StickyEthan/ContinuO_Library/README.md

# ContinuO_Library
 Library dependency of REPOWER-ContinuO projects (GIT Submodule)
