StickyEthan/ContinuO_Library/3D_models/XT60PW-M.STEP

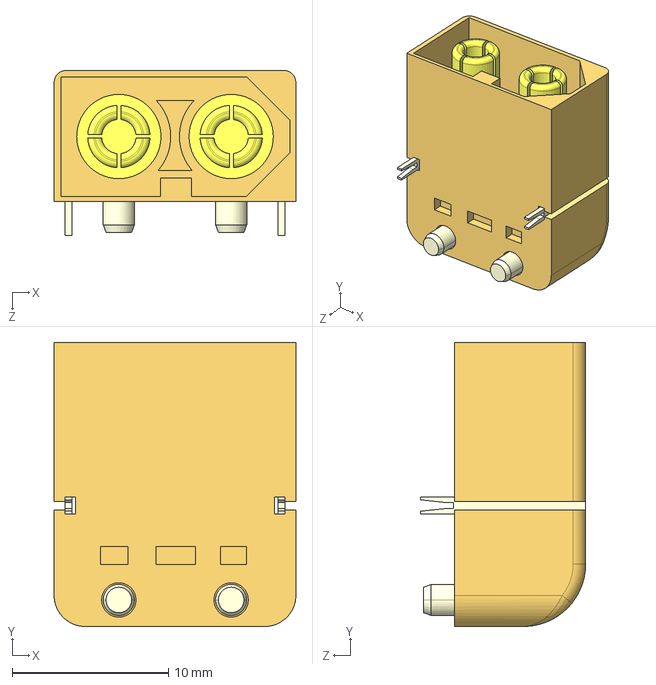
[picture p1: CAD file, 2025-01-31]
3D_models/XT60PW-M.STEP
15.5 x 18.2 x 10.6 mm
