StickyEthan/ContinuO_Library/3D_models/1211.stp

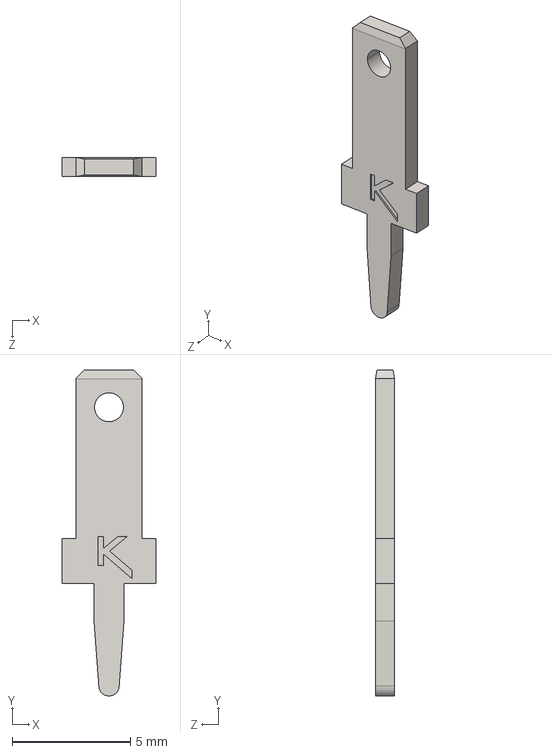
[picture p2: CAD file, 2025-01-27]
3D_models/1211.stp
3.96 x 13.8 x 0.813 mm
