StickyEthan/ContinuO_Library/3D_models/c-62395-1-ae-3d.stp

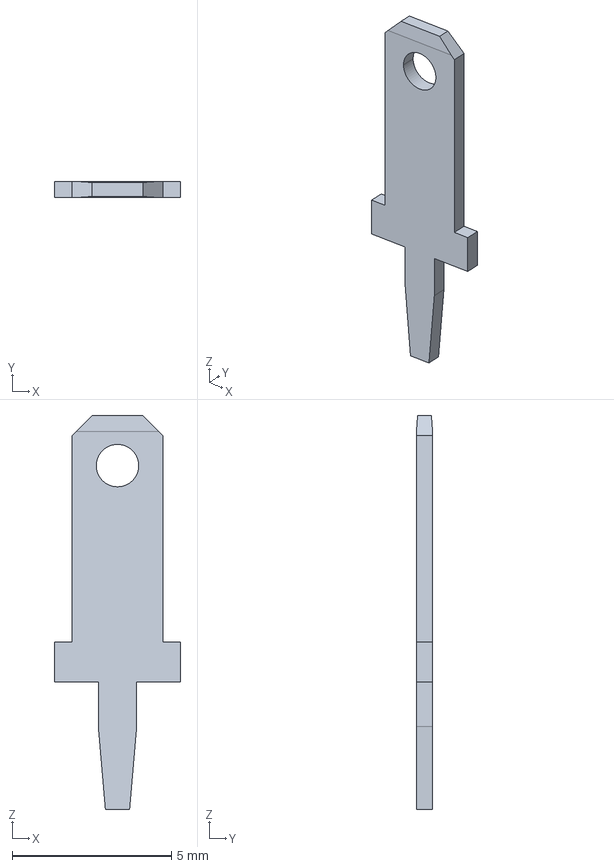
[picture p3: CAD file, 2025-01-27]
3D_models/c-62395-1-ae-3d.stp
3.96 x 0.508 x 12.4 mm
