StickyEthan/ContinuO_Library/3D_models/SMDJSeries_LTF.step

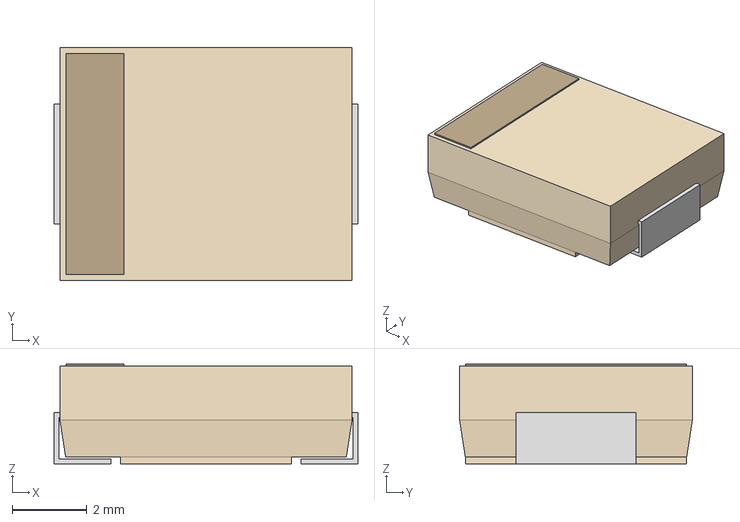
[picture p4: CAD file, 2025-01-22]
3D_models/SMDJSeries_LTF.step
8.13 x 6.22 x 2.67 mm
