StickyEthan/ContinuO_Library/3D_models/FUSE_0505-CARTRIDGE_LTF.step

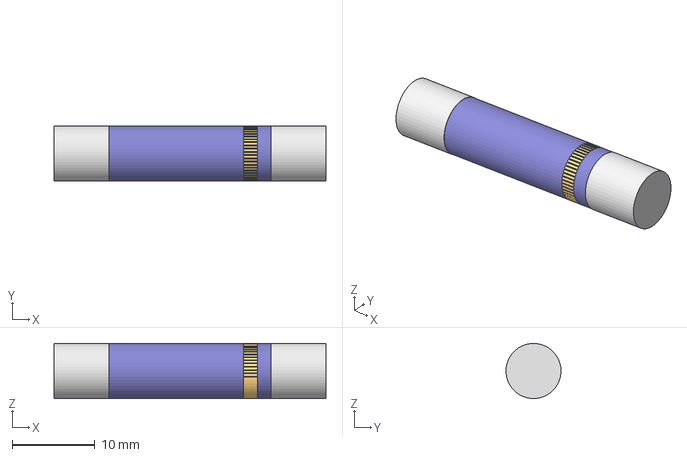
[picture p5: CAD file, 2025-01-16]
3D_models/FUSE_0505-CARTRIDGE_LTF.step
32.9 x 6.65 x 6.65 mm
