StickyEthan/ContinuO_Library/3D_models/UMF250.STEP

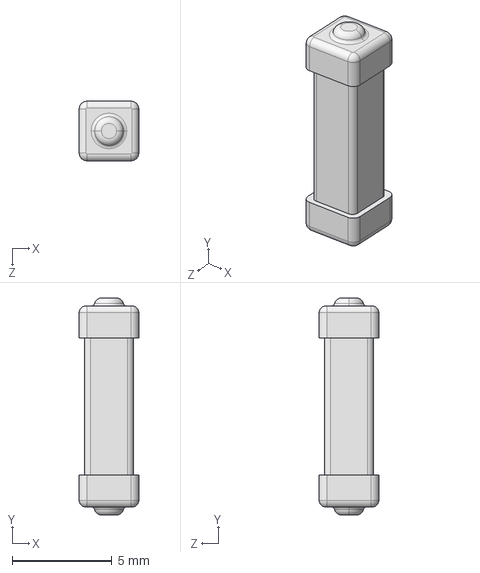
[picture p6: CAD file, 2025-01-14]
3D_models/UMF250.STEP
3.00 x 10.9 x 3.00 mm
