StickyEthan/ContinuO_Library/3D_models/217-36CTE6.stp

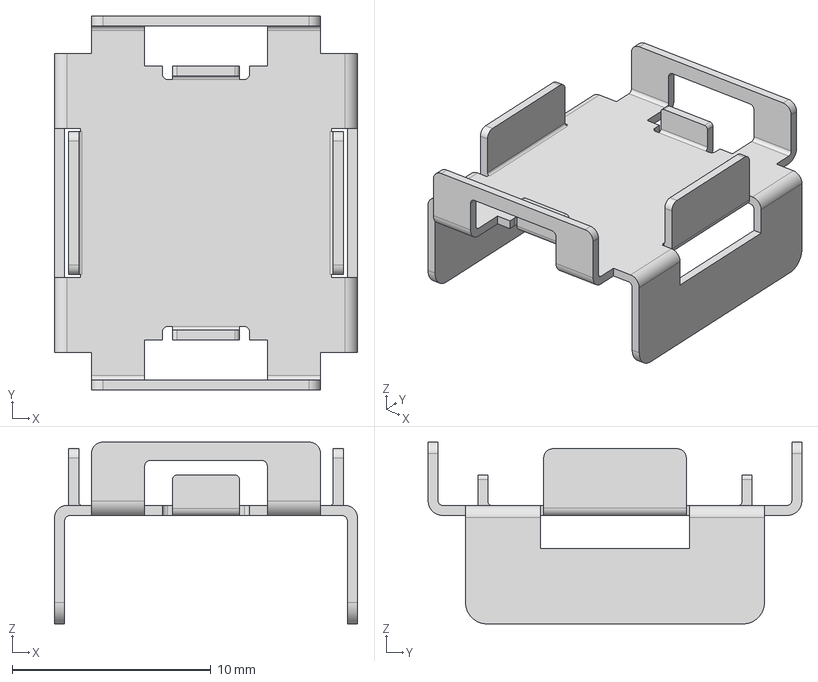
[picture p7: CAD file, 2025-01-14]
3D_models/217-36CTE6.stp
15.2 x 18.8 x 9.14 mm
