StickyEthan/ContinuO_Library/3D_models/Shunt Resistor v2.step

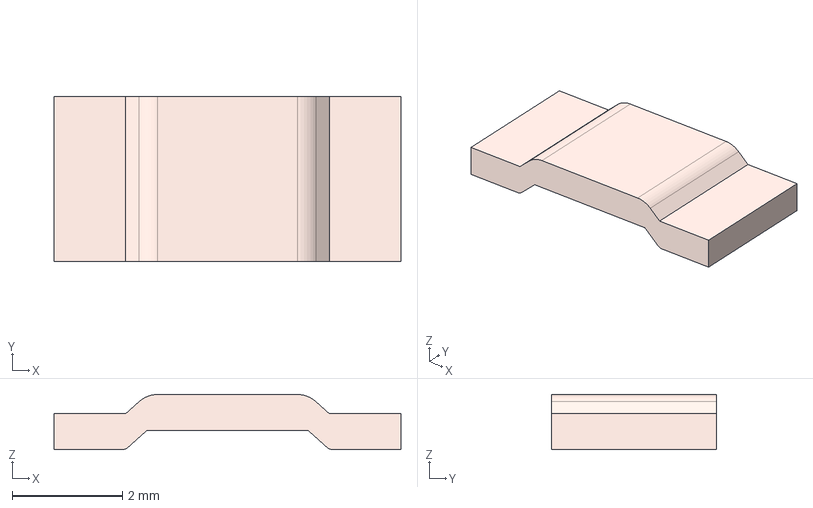
[picture p8: CAD file, 2025-01-14]
3D_models/Shunt Resistor v2.step
6.30 x 3.00 x 1.00 mm
