StickyEthan/ContinuO_Library/3D_models/Same_Sky_TBP01P1-508-02BE.step

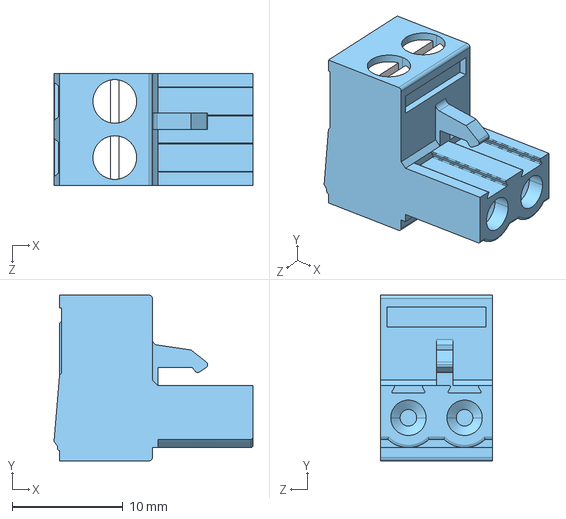
[picture p9: CAD file, 2025-01-14]
3D_models/Same_Sky_TBP01P1-508-02BE.step
18.0 x 15.0 x 10.2 mm
