StickyEthan/ContinuO_Library/3D_models/CAP_PKPZ_8X11P5_LOW_RUB.step

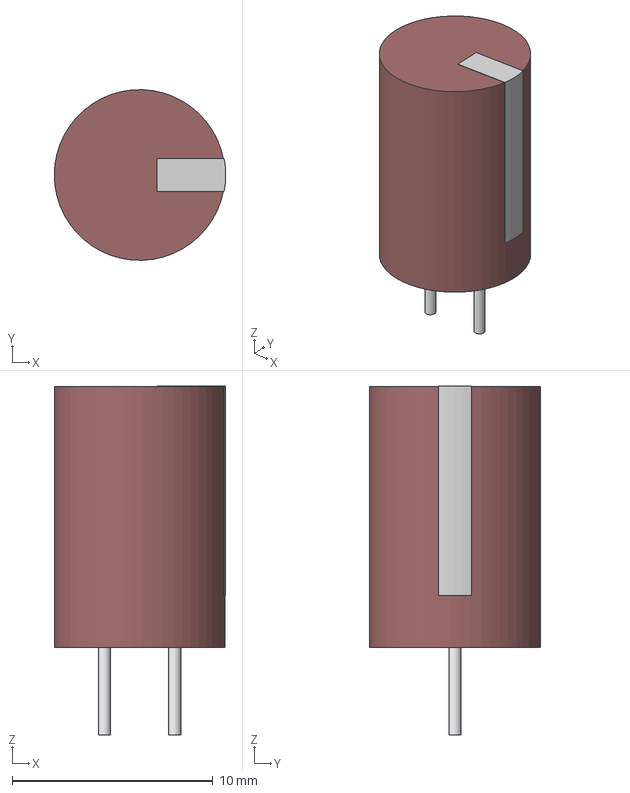
[picture p10: CAD file, 2025-01-14]
3D_models/CAP_PKPZ_8X11P5_LOW_RUB.step
8.54 x 8.50 x 17.4 mm
