StickyEthan/ContinuO_Library/3D_models/TBP01R2-508-02BE_male.step

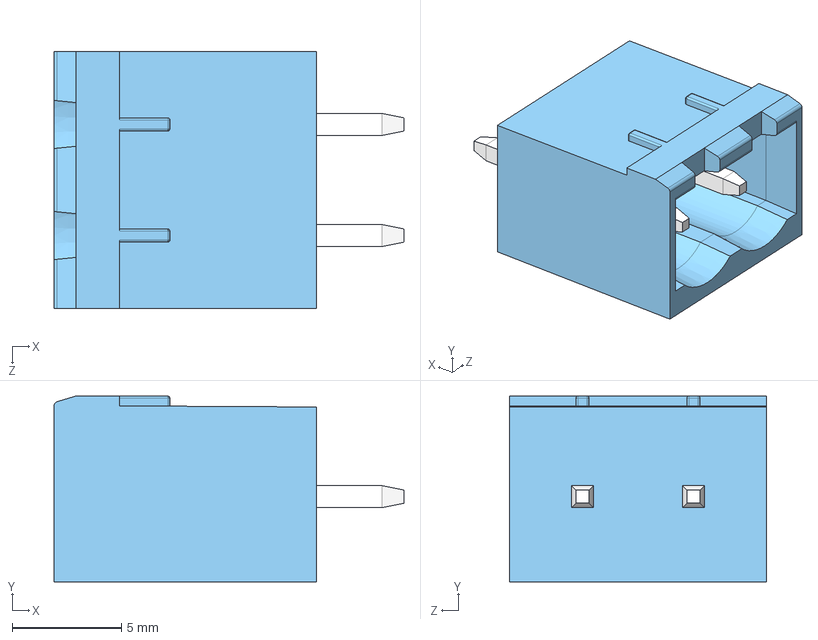
[picture p11: CAD file, 2025-01-14]
3D_models/TBP01R2-508-02BE_male.step
16.0 x 8.50 x 11.8 mm
