StickyEthan/ContinuO_Library/3D_models/RDA0015A.stp

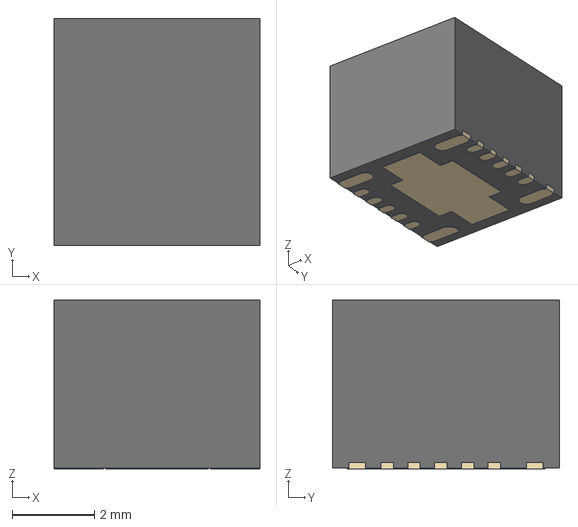
[picture p12: CAD file, 2025-01-14]
3D_models/RDA0015A.stp
5.00 x 5.50 x 4.10 mm
METAL
MOLD
