StickyEthan/ContinuO_Library/3D_models/S02B-PASK-2.STEP

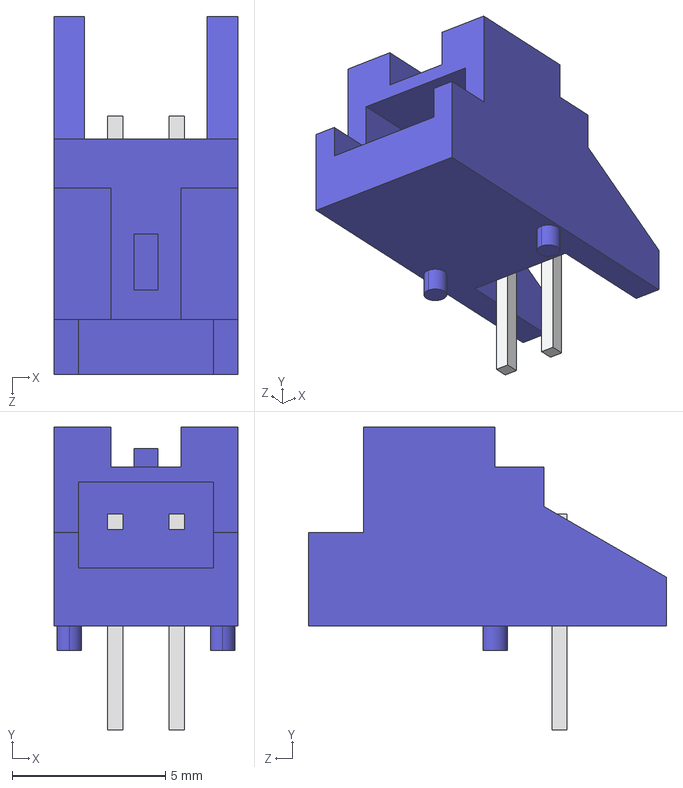
[picture p13: CAD file, 2025-01-13]
3D_models/S02B-PASK-2.STEP
6.00 x 9.90 x 11.7 mm
