StickyEthan/ContinuO_Library/3D_models/CAP_BX_12P5x30_RUB.step

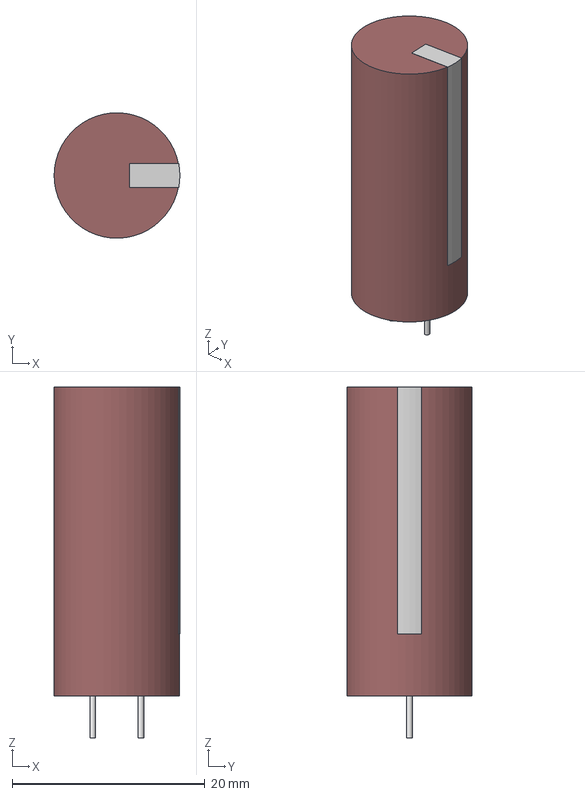
[picture p14: CAD file, 2025-01-12]
3D_models/CAP_BX_12P5x30_RUB.step
13.0 x 13.0 x 36.4 mm
