StickyEthan/ContinuO_Library/3D_models/DDF0008A.stp

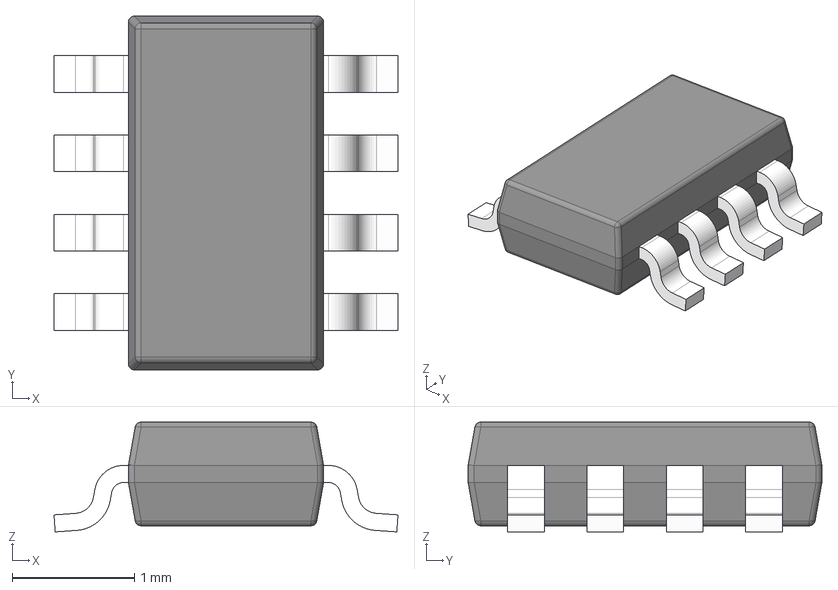
[picture p15: CAD file, 2025-01-09]
3D_models/DDF0008A.stp
2.82 x 2.90 x 0.9 mm
BODY-SO
LEAD-SO x 8
PIN1-ID
