StickyEthan/ContinuO_Library/3D_models/CAP_YX_12P5X25_RUB.step

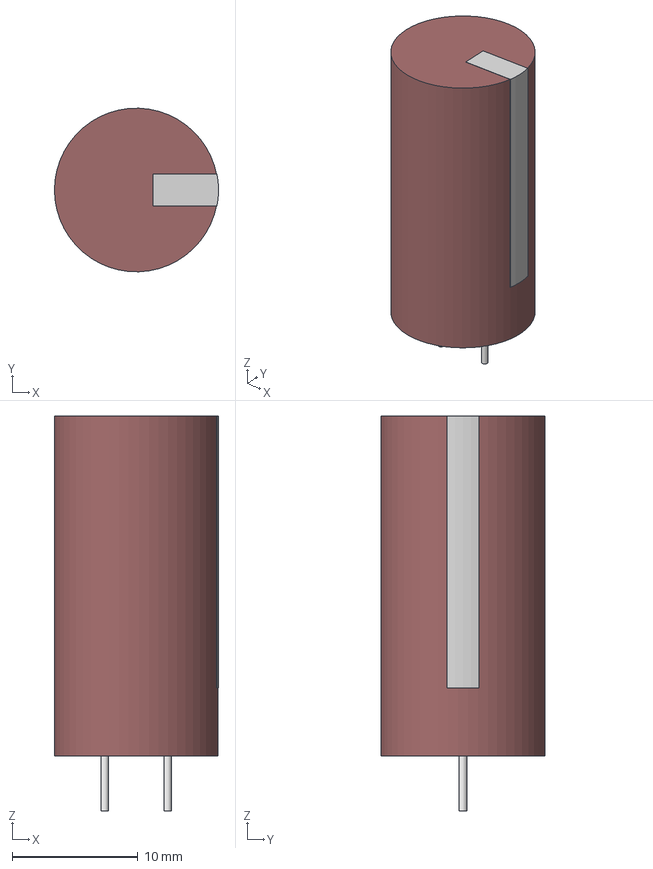
[picture p16: CAD file, 2025-01-02]
3D_models/CAP_YX_12P5X25_RUB.step
13.0 x 13.0 x 31.4 mm
