StickyEthan/ContinuO_Library/3D_models/LFPAK88_SOT1235_NEX.step

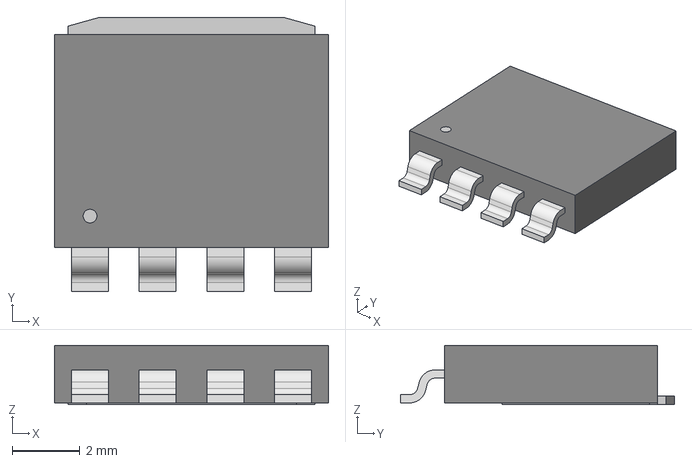
[picture p17: CAD file, 2024-12-31]
3D_models/LFPAK88_SOT1235_NEX.step
8.10 x 8.10 x 1.75 mm
