StickyEthan/ContinuO_Library/3D_models/DGK0008A.stp

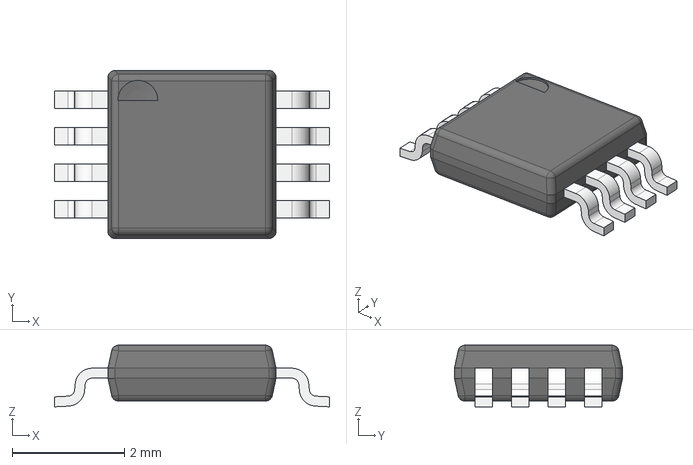
[picture p18: CAD file, 2024-12-31]
3D_models/DGK0008A.stp
4.90 x 3.00 x 1.10 mm
BODY_MUA08A
LEAD_MUA08A x 8
