StickyEthan/ContinuO_Library/3D_models/HSE05-171933.step

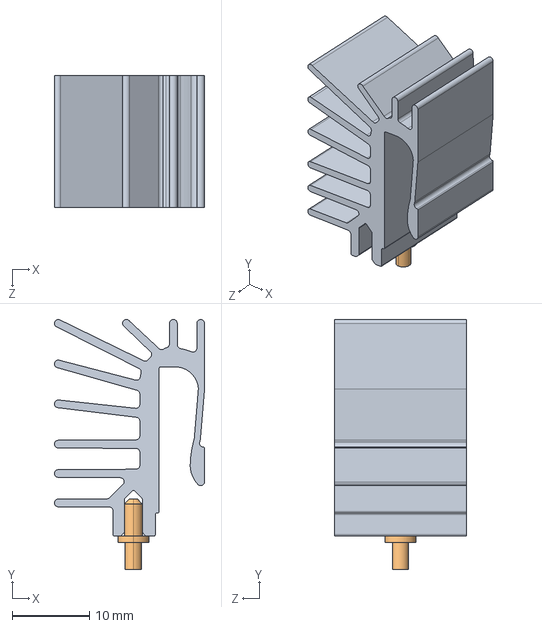
[picture p19: CAD file, 2024-12-31]
3D_models/HSE05-171933.step
19.4 x 32.3 x 17.0 mm
