StickyEthan/ContinuO_Library/3D_models/PF2203_2RF1.step

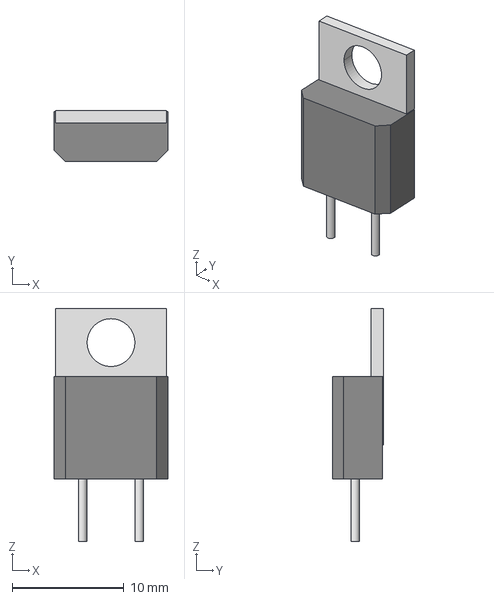
[picture p20: CAD file, 2024-12-31]
3D_models/PF2203_2RF1.step
10.2 x 4.57 x 20.8 mm
