StickyEthan/ContinuO_Library/3D_models/A785MW227M1HLAS015.stp

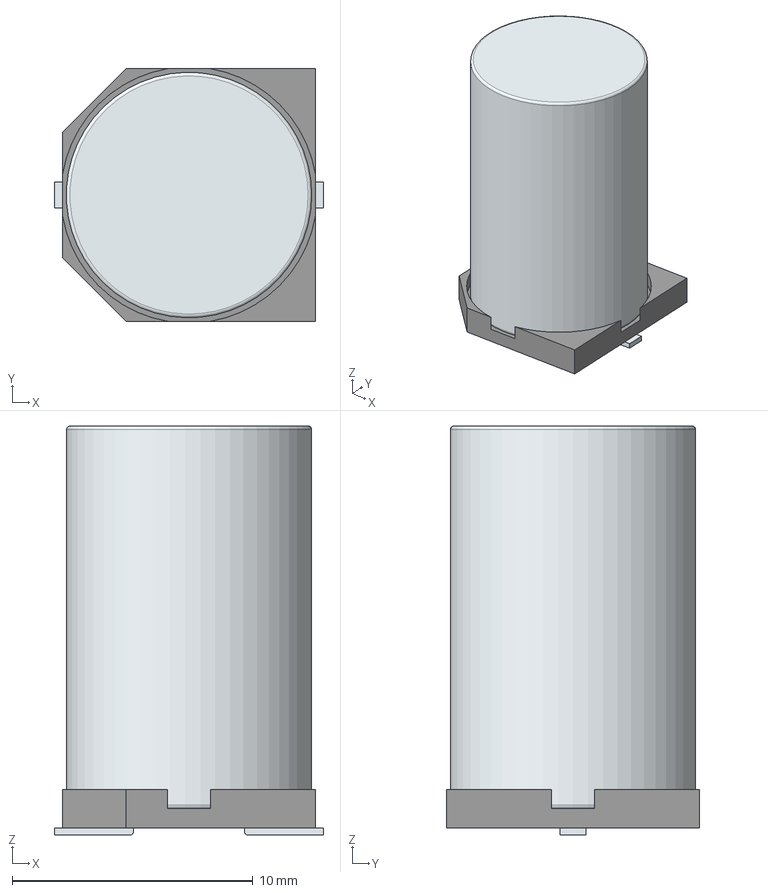
[picture p21: CAD file, 2024-12-11]
3D_models/A785MW227M1HLAS015.stp
11.2 x 10.5 x 17.0 mm
Base
Pin1Fillet
Pin2Fillet
