StickyEthan/ContinuO_Library/3D_models/V-1100-SMD.STEP

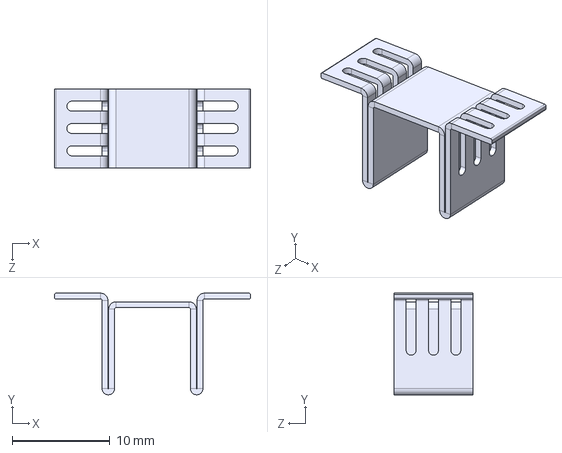
[picture p22: CAD file, 2024-12-11]
3D_models/V-1100-SMD.STEP
20.1 x 10.4 x 8.13 mm
