StickyEthan/ContinuO_Library/3D_models/ESL108M035AK5AA.step

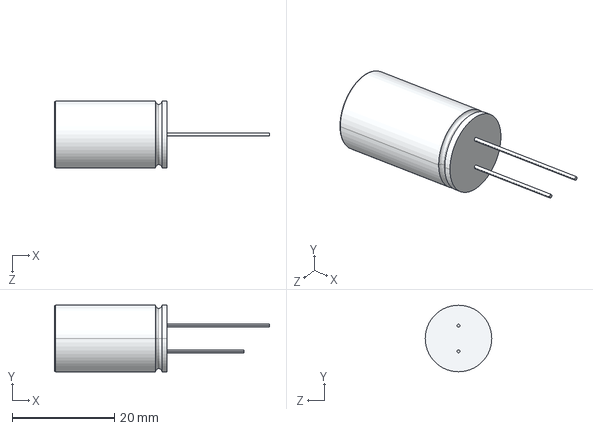
[picture p23: CAD file, 2024-12-11]
3D_models/ESL108M035AK5AA.step
42.0 x 13.0 x 13.0 mm
