StickyEthan/ContinuO_Library/3D_models/MF-MSMF075_24-2.step

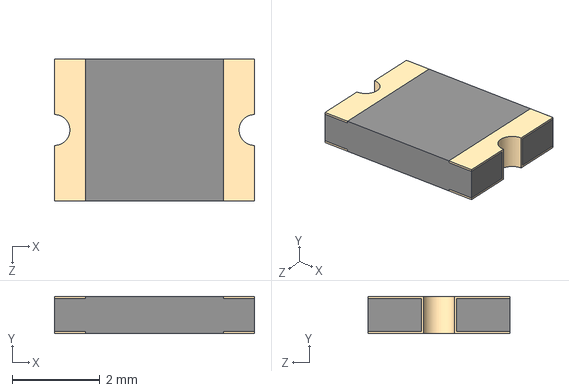
[picture p24: CAD file, 2024-11-30]
3D_models/MF-MSMF075_24-2.step
4.55 x 0.85 x 3.24 mm
