StickyEthan/ContinuO_Library/3D_models/BMR684_heatsink.stp

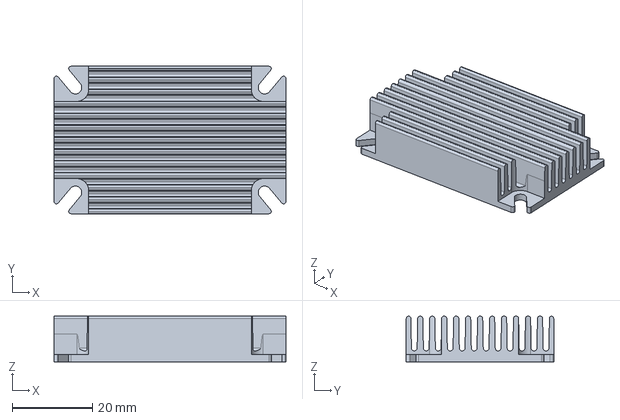
[picture p25: CAD file, 2024-11-29]
3D_models/BMR684_heatsink.stp
57.9 x 36.8 x 11.4 mm
