StickyEthan/ContinuO_Library/3D_models/UMZ250.STEP

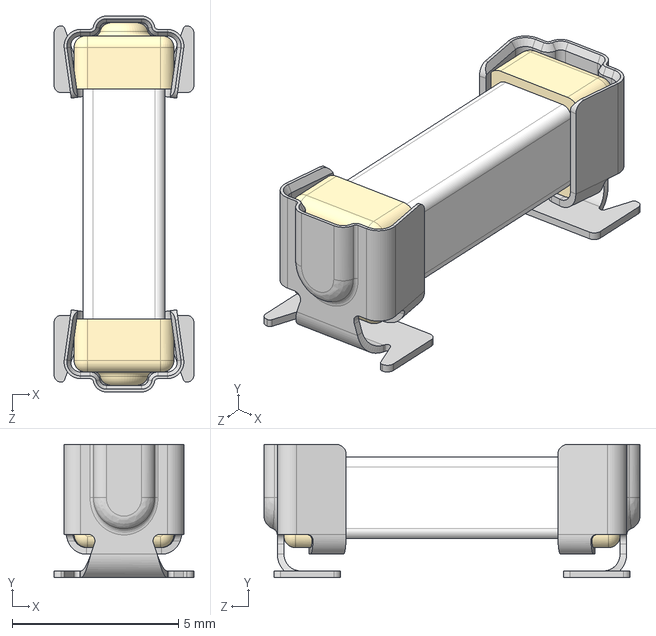
[picture p26: CAD file, 2024-11-29]
3D_models/UMZ250.STEP
4.20 x 4.00 x 11.3 mm
