StickyEthan/ContinuO_Library/3D_models/UMT-H.step

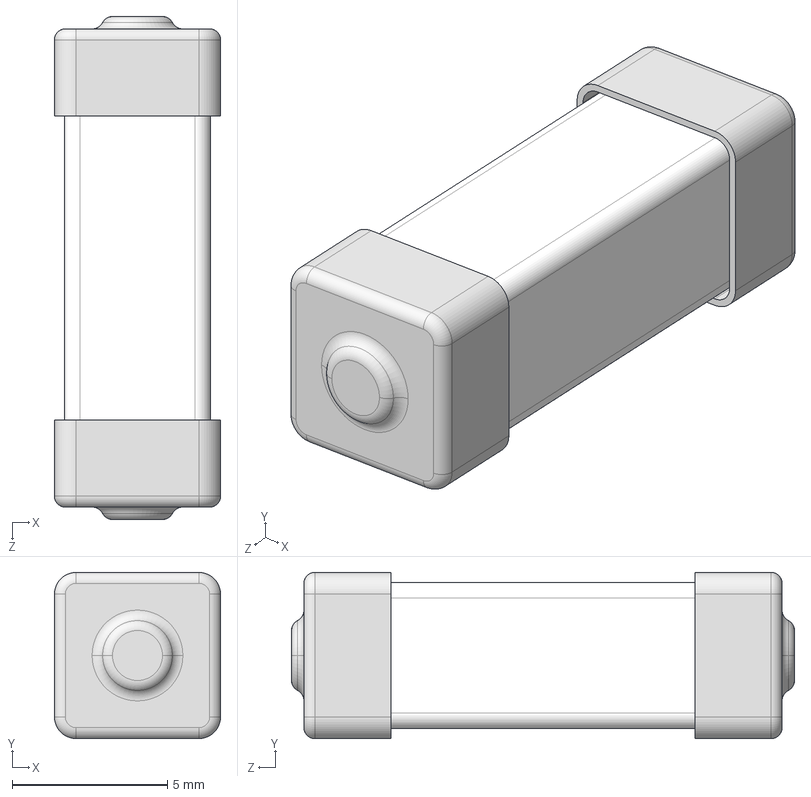
[picture p27: CAD file, 2024-11-29]
3D_models/UMT-H.step
5.35 x 5.35 x 16.2 mm
