StickyEthan/ContinuO_Library/3D_models/B02B-PASK-1.step

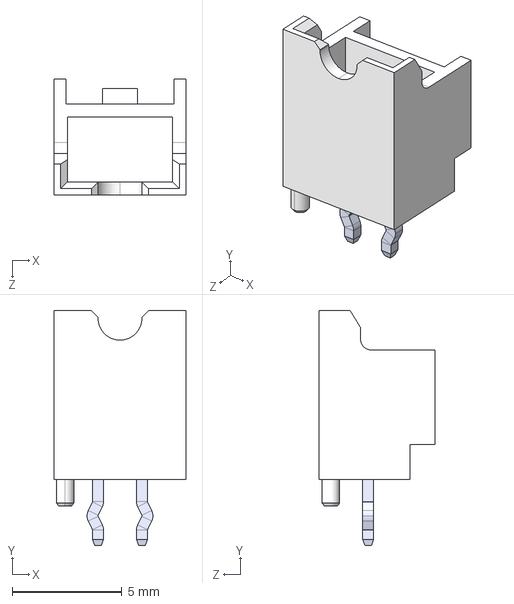
[picture p28: CAD file, 2024-11-28]
3D_models/B02B-PASK-1.step
6.00 x 10.7 x 5.30 mm
BxB-PASK(1)2-9_2boss
pin_bent x 2
