StickyEthan/ContinuO_Library/3D_models/S03B-PASK-2_LF__SN_.stp

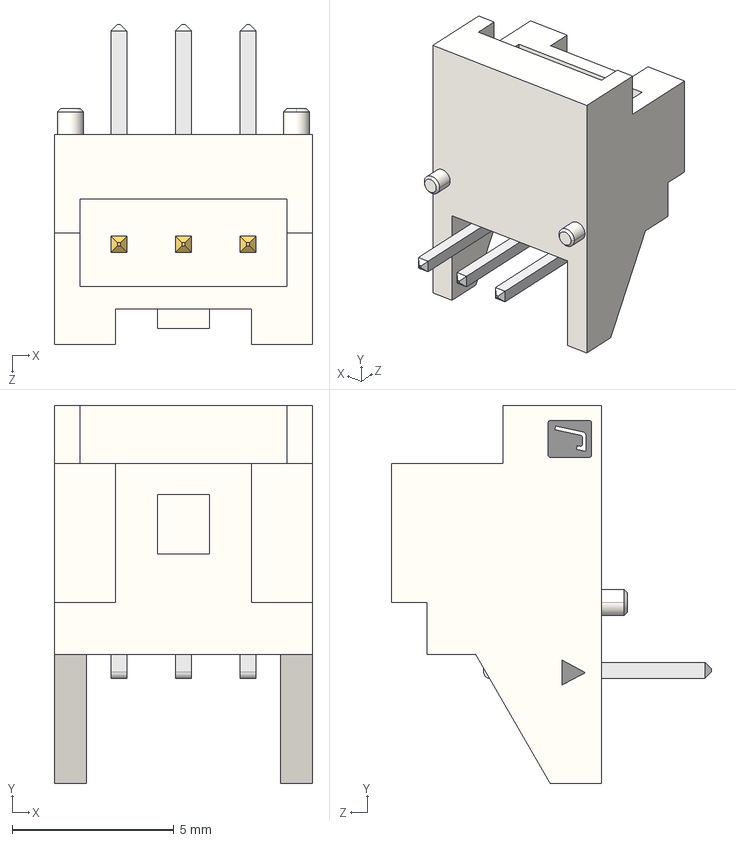
[picture p29: CAD file, 2024-11-28]
3D_models/S03B-PASK-2_LF__SN_.stp
8.00 x 11.7 x 9.90 mm
S03B-PASK-2
JST Logo adjustable
