StickyEthan/ContinuO_Library/3D_models/HTSW-102-07-F-D.step

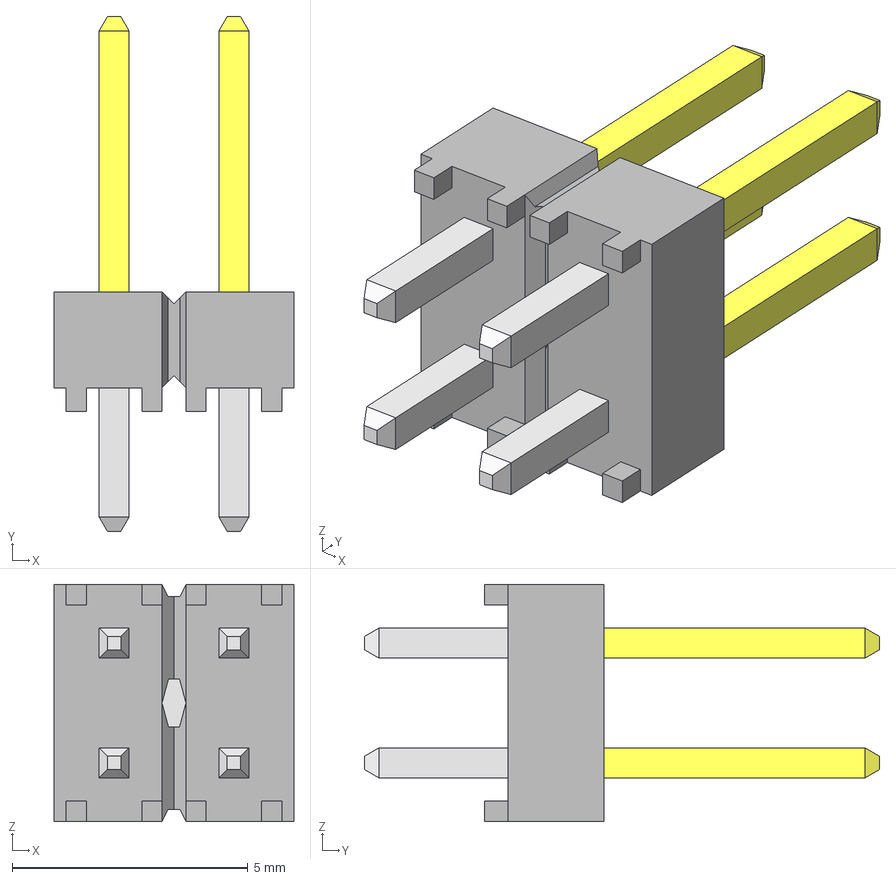
[picture p30: CAD file, 2024-11-28]
3D_models/HTSW-102-07-F-D.step
5.08 x 10.9 x 5.03 mm
HTSW-102-07-F-D_body
T-1S6-07-HTSW-1--07-2--F-D
T-1S6-07-HTSW-1--07-2--F-D2
