StickyEthan/ContinuO_Library/3D_models/to252-4.stp

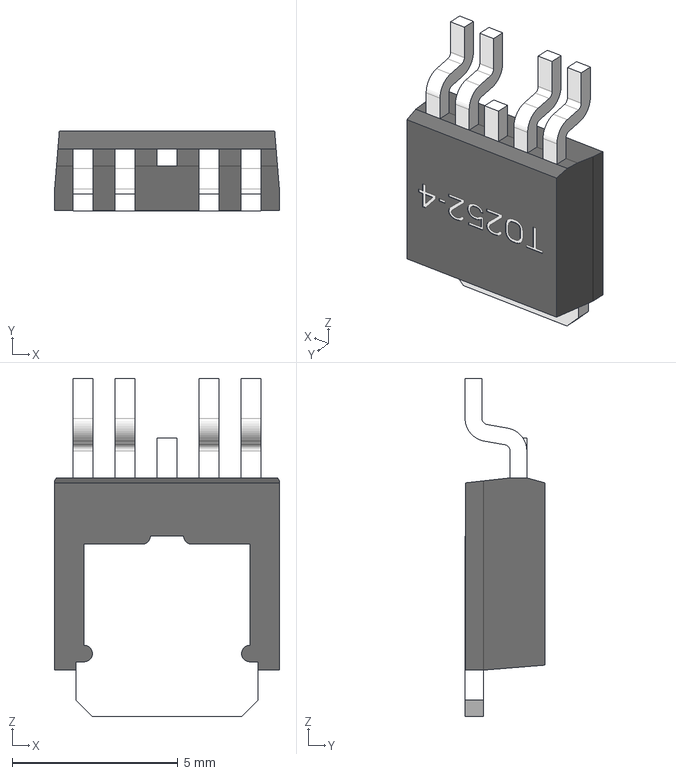
[picture p31: CAD file, 2024-11-28]
3D_models/to252-4.stp
6.80 x 2.41 x 10.2 mm
