StickyEthan/ContinuO_Library/3D_models/D0014A.stp

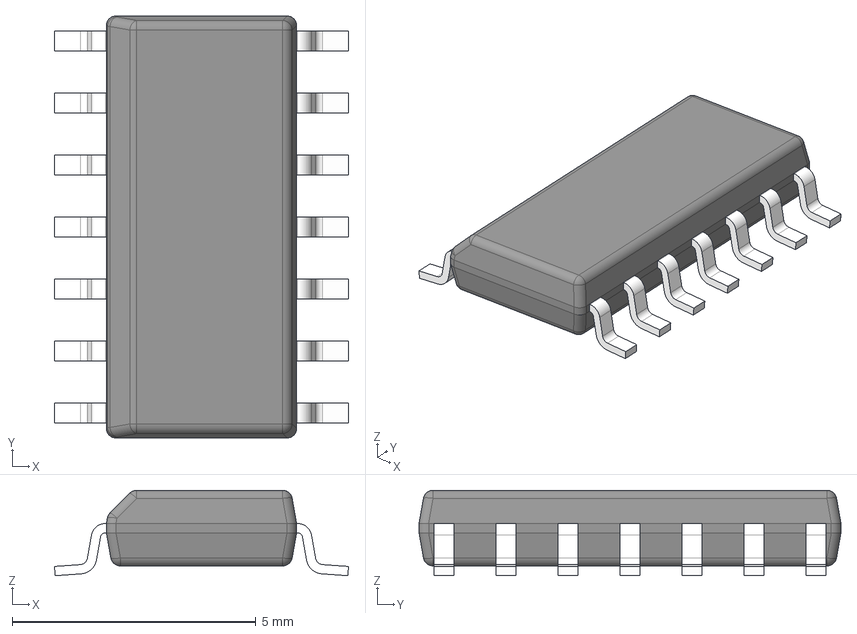
[picture p32: CAD file, 2024-11-27]
3D_models/D0014A.stp
6.03 x 8.65 x 1.75 mm
BODY-SO
LEAD-SO x 14
PIN1-ID
