StickyEthan/ContinuO_Library/3D_models/WCAP-AT1H_5X11.step

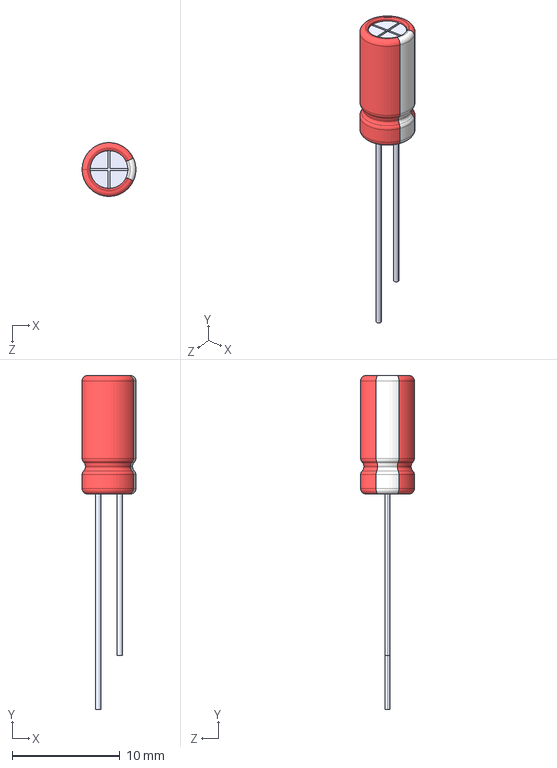
[picture p33: CAD file, 2024-11-27]
3D_models/WCAP-AT1H_5X11.step
5.00 x 31.0 x 5.00 mm
