StickyEthan/ContinuO_Library/3D_models/LTV-826S_LTO.step

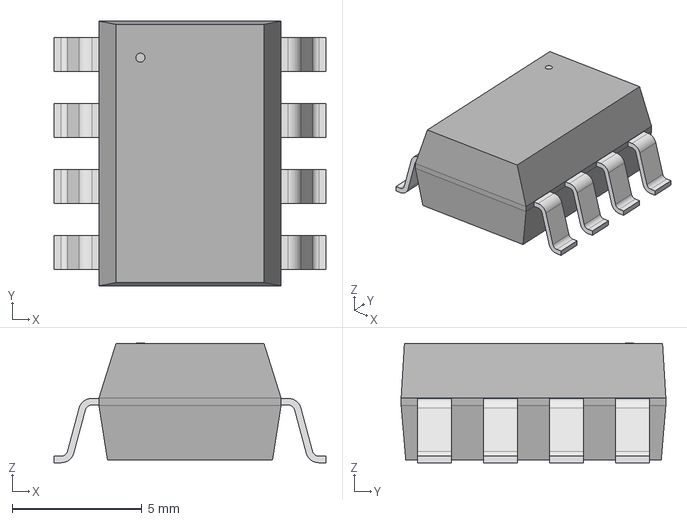
[picture p34: CAD file, 2024-11-27]
3D_models/LTV-826S_LTO.step
10.5 x 10.2 x 4.60 mm
