StickyEthan/ContinuO_Library/3D_models/D5V0P4URL6SO_7_SOT26_DIO.step

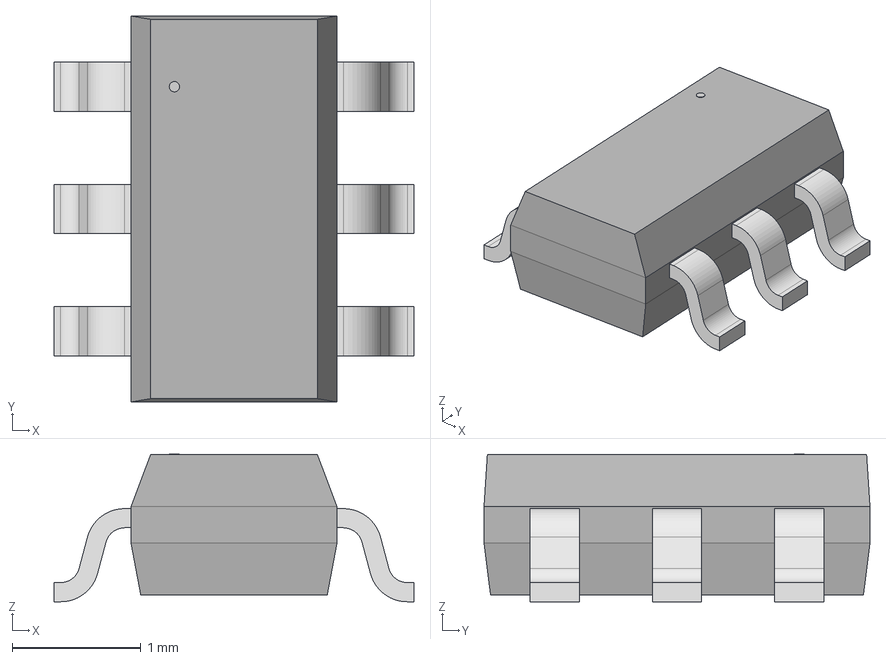
[picture p35: CAD file, 2024-11-27]
3D_models/D5V0P4URL6SO_7_SOT26_DIO.step
2.79 x 3.00 x 1.15 mm
