StickyEthan/ContinuO_Library/3D_models/sod-123f.stp

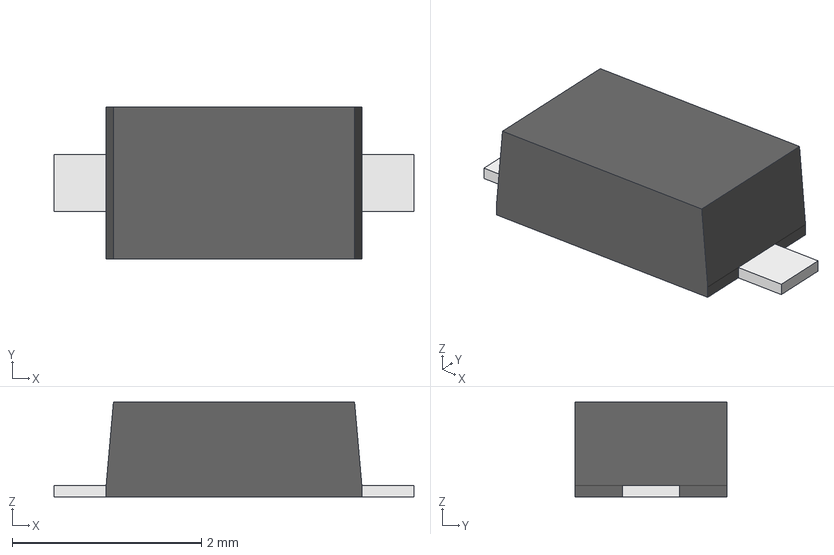
[picture p36: CAD file, 2024-11-27]
3D_models/sod-123f.stp
3.80 x 1.60 x 1.00 mm
