StickyEthan/ContinuO_Library/3D_models/DBV0006A.stp

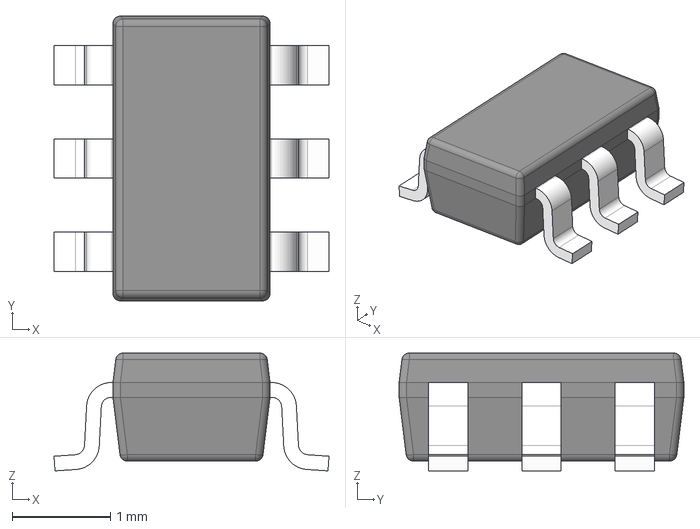
[picture p37: CAD file, 2024-11-27]
3D_models/DBV0006A.stp
2.80 x 2.90 x 1.20 mm
BODY-SOT
LEAD-SOT x 6
