StickyEthan/ContinuO_Library/3D_models/DYY0014A.stp

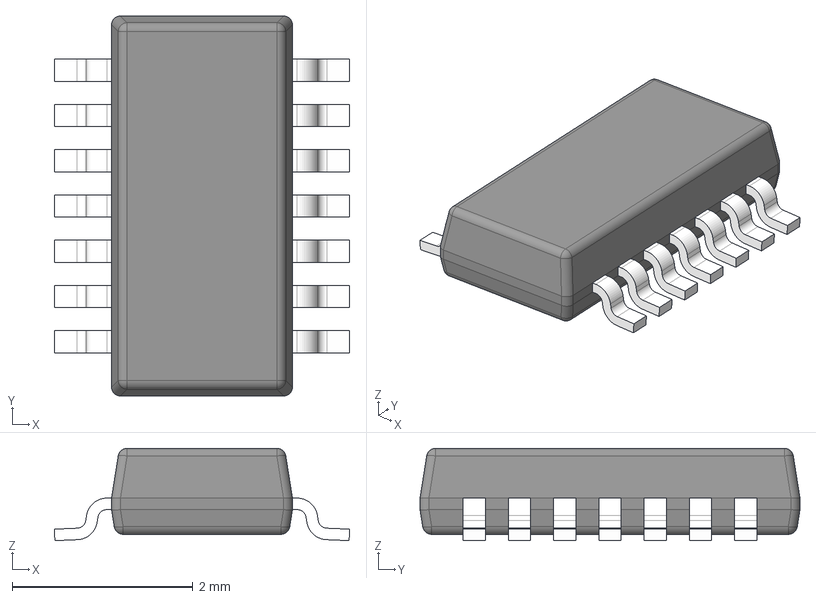
[picture p38: CAD file, 2024-11-27]
3D_models/DYY0014A.stp
3.26 x 4.20 x 1.02 mm
BODY-TSSOP
LEAD-TSSOP x 14
