StickyEthan/ContinuO_Library/3D_models/PW0014A.stp

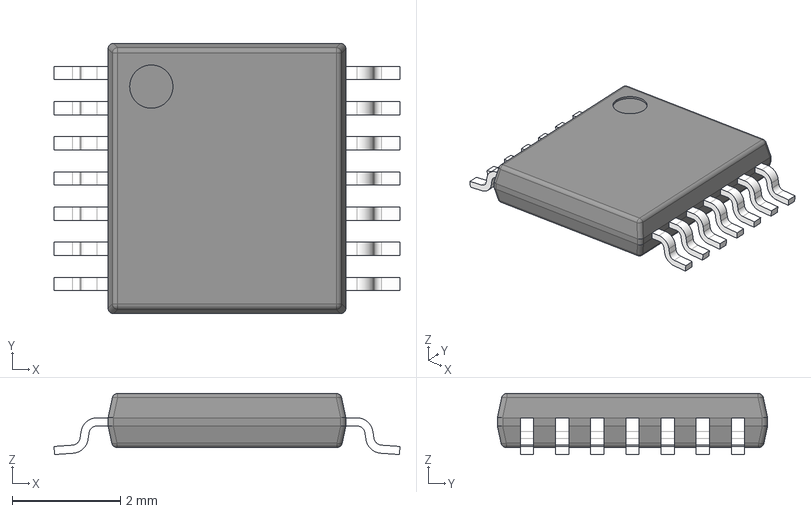
[picture p39: CAD file, 2024-11-27]
3D_models/PW0014A.stp
6.40 x 5.00 x 1.13 mm
BODY-TSSOP
LEAD-TSSOP x 14
PIN1
