StickyEthan/ContinuO_Library/3D_models/DS01C-254-S-04BE.step

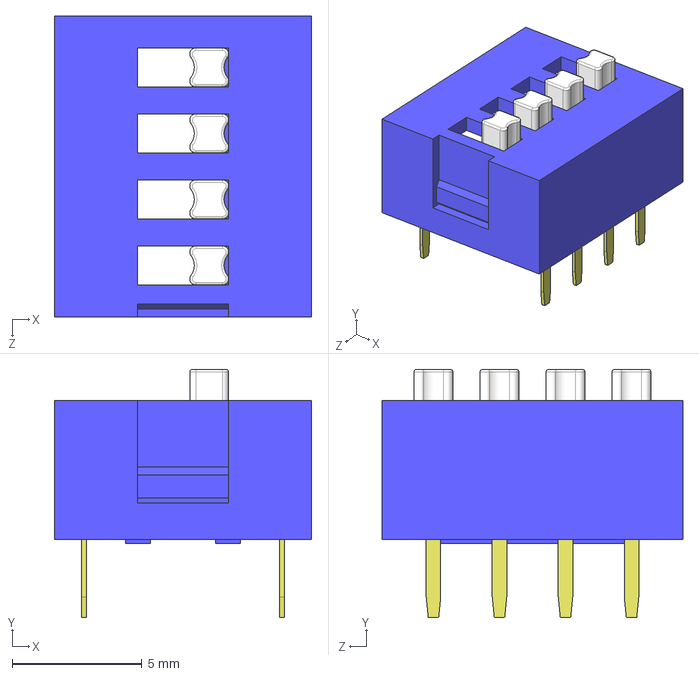
[picture p40: CAD file, 2024-11-27]
3D_models/DS01C-254-S-04BE.step
9.90 x 9.55 x 11.6 mm
