StickyEthan/ContinuO_Library/3D_models/do-214aa-smb.stp

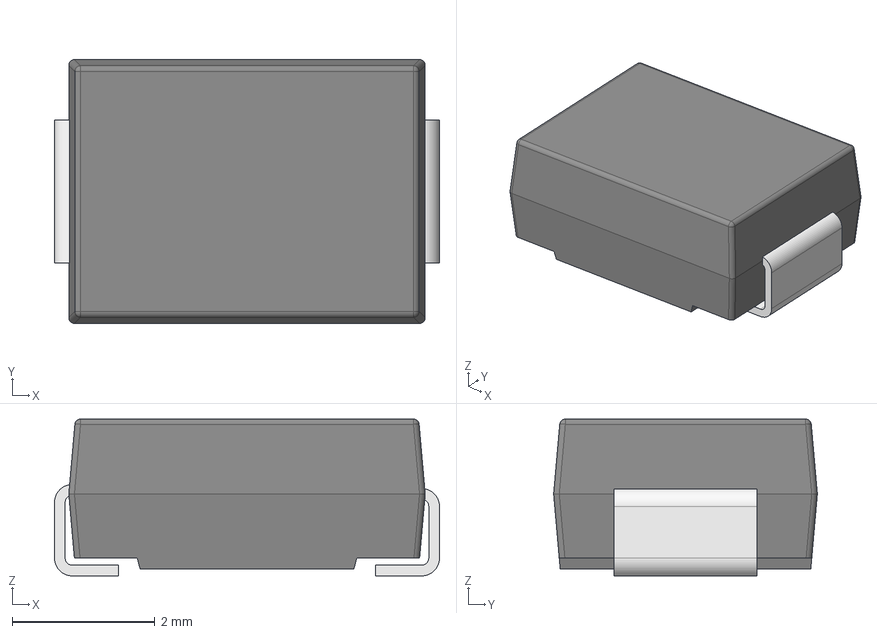
[picture p41: CAD file, 2024-11-27]
3D_models/do-214aa-smb.stp
5.40 x 3.70 x 2.20 mm
