StickyEthan/ContinuO_Library/3D_models/CON4_2X2_TU_TSW_SAI.step

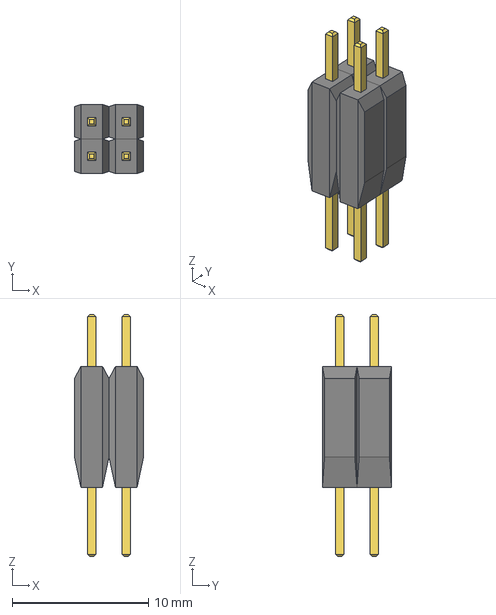
[picture p42: CAD file, 2024-11-27]
3D_models/CON4_2X2_TU_TSW_SAI.step
5.08 x 5.08 x 17.8 mm
