StickyEthan/ContinuO_Library/3D_models/WL-OCPT_SERIES_101X.step

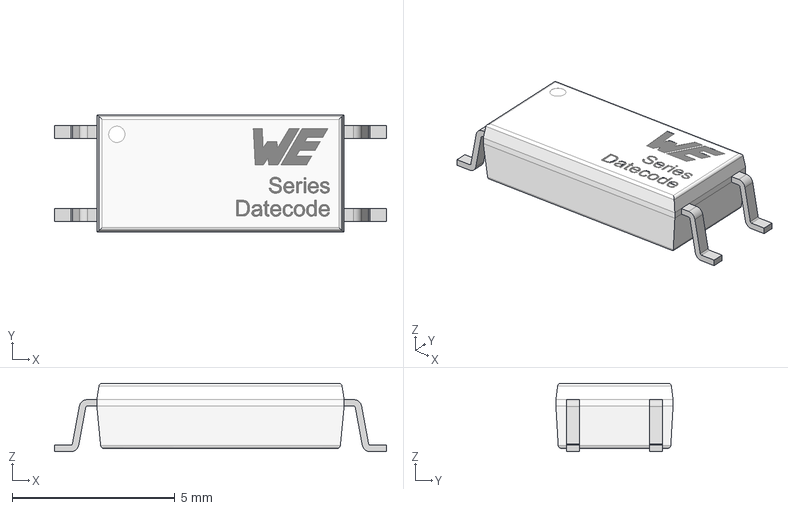
[picture p43: CAD file, 2024-11-27]
3D_models/WL-OCPT_SERIES_101X.step
10.2 x 3.60 x 2.10 mm
Pin
