StickyEthan/ContinuO_Library/3D_models/CMI-1210_CUD.step

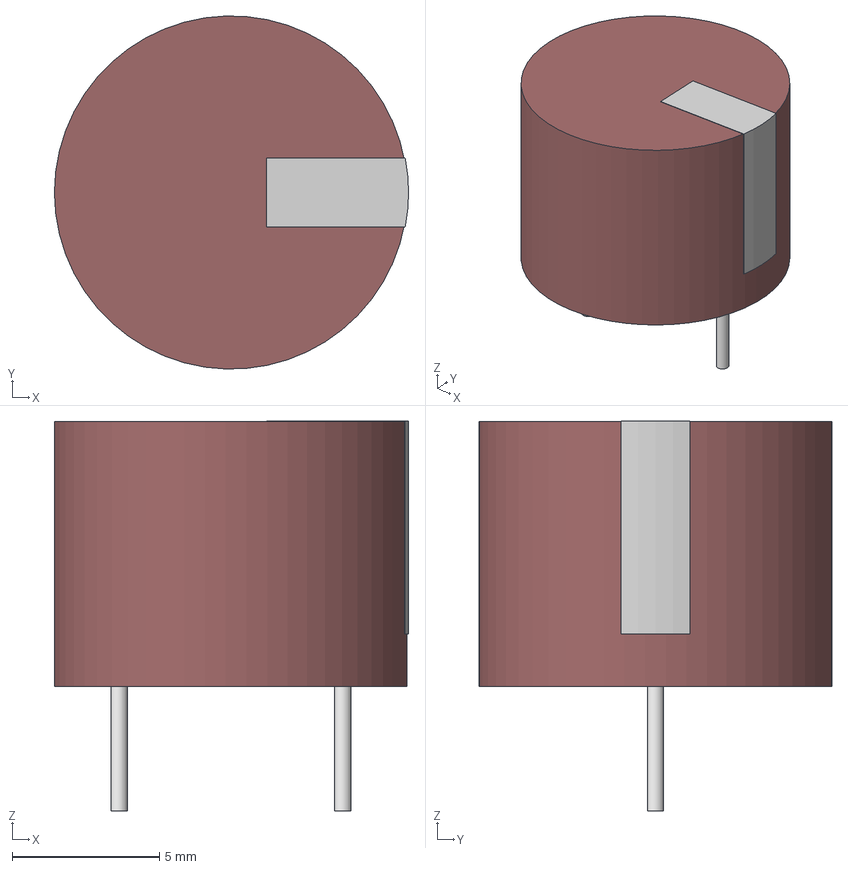
[picture p44: CAD file, 2024-11-27]
3D_models/CMI-1210_CUD.step
12.0 x 12.0 x 13.2 mm
