StickyEthan/ContinuO_Library/3D_models/B02B-XASK-1.step

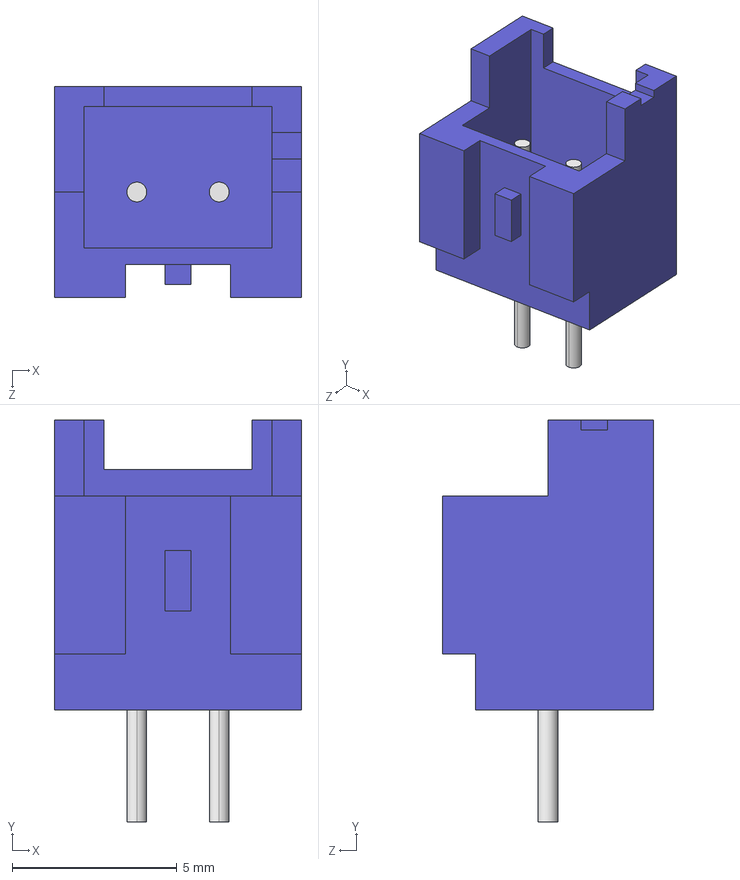
[picture p46: CAD file, 2024-11-27]
3D_models/B02B-XASK-1.step
7.50 x 12.2 x 6.40 mm
