StickyEthan/ContinuO_Library/3D_models/RPMGS12-20.stp

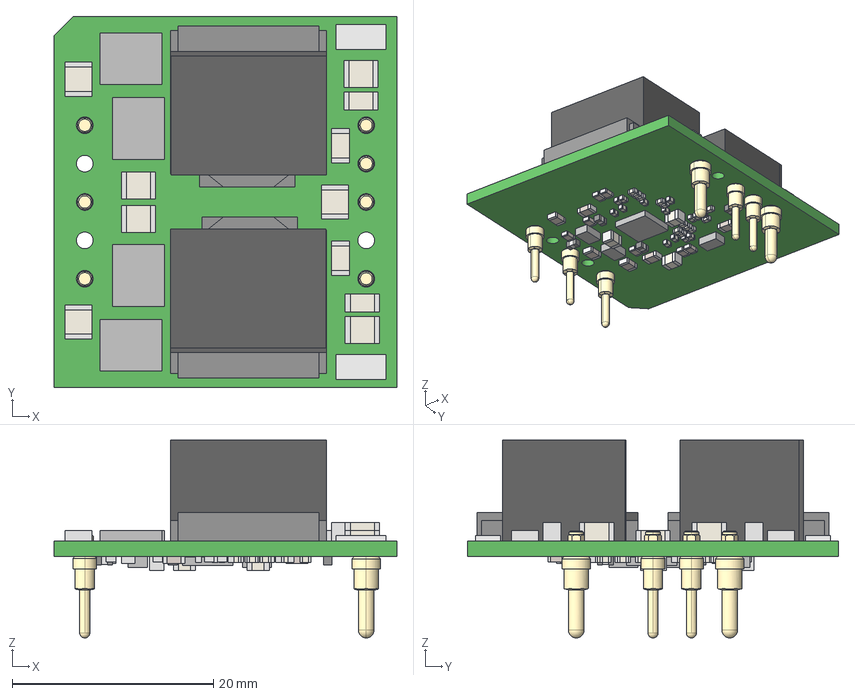
[picture p47: CAD file, 2024-11-25]
3D_models/RPMGS12-20.stp
34.0 x 36.8 x 19.7 mm
Extruded x 184
mill-max-6035-0-00-15-00-00-03-0 x 2
mill-max-6025-0-00-15-00-00-03-0 x 5
CircuitWorks-CAPACITOR_0603 x 12
