StickyEthan/ContinuO_Library/3D_models/0031.8221.step

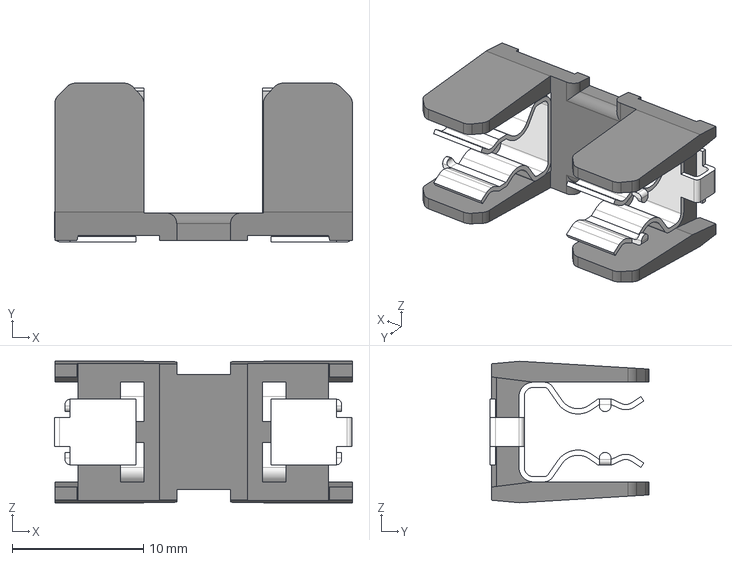
[picture p48: CAD file, 2024-11-25]
3D_models/0031.8221.step
22.7 x 12.1 x 10.8 mm
