StickyEthan/ContinuO_Library/3D_models/0031.8241.step

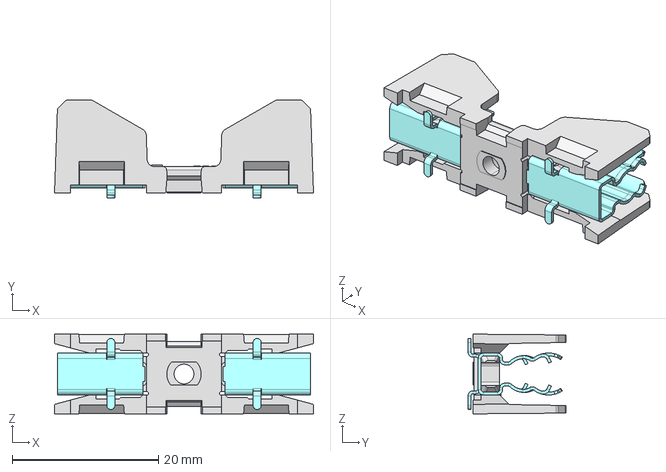
[picture p49: CAD file, 2024-11-25]
3D_models/0031.8241.step
35.4 x 13.4 x 10.9 mm
