StickyEthan/ContinuO_Library/3D_models/LM4030CMF-4.096_NOPB.step

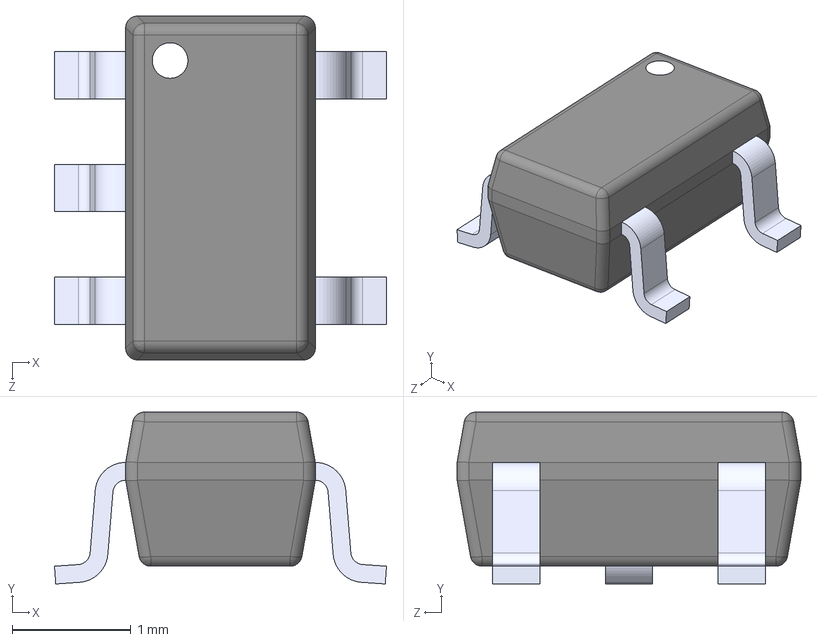
[picture p50: CAD file, 2024-11-08]
3D_models/LM4030CMF-4.096_NOPB.step
2.80 x 1.45 x 2.90 mm
