StickyEthan/ContinuO_Library/3D_models/XT90PW-M.step

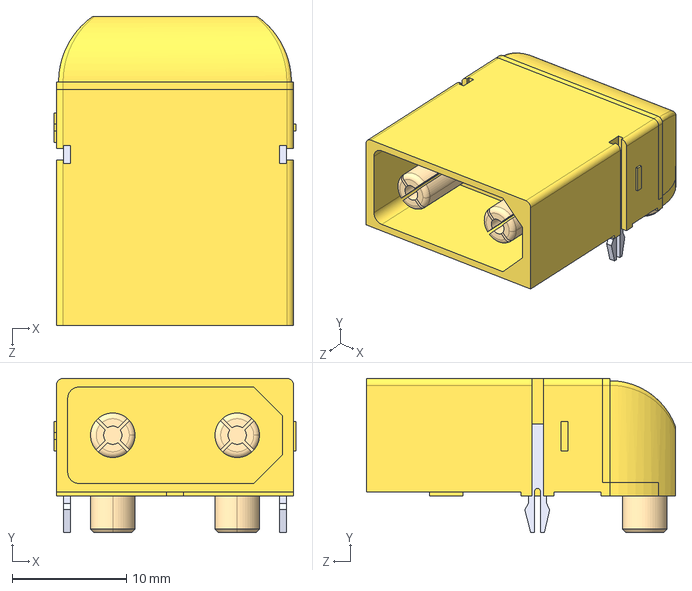
[picture p51: CAD file, 2024-11-08]
3D_models/XT90PW-M.step
21.2 x 13.5 x 27.1 mm
