StickyEthan/ContinuO_Library/3D_models/XT30PW-M.step

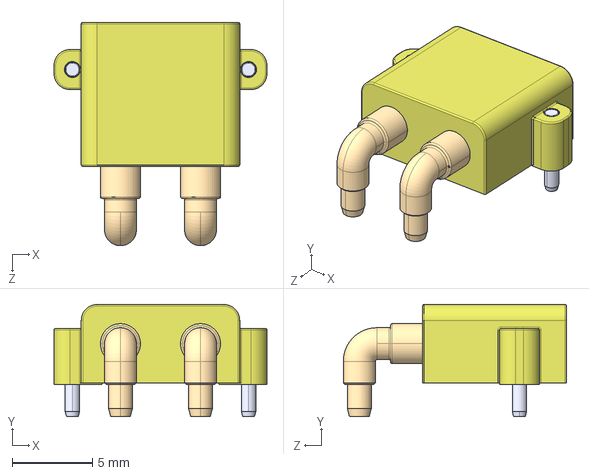
[picture p52: CAD file, 2024-11-08]
3D_models/XT30PW-M.step
13.3 x 7.00 x 14.0 mm
