StickyEthan/ContinuO_Library/3D_models/i7A4W033A033V-xF3-R_TDK.step

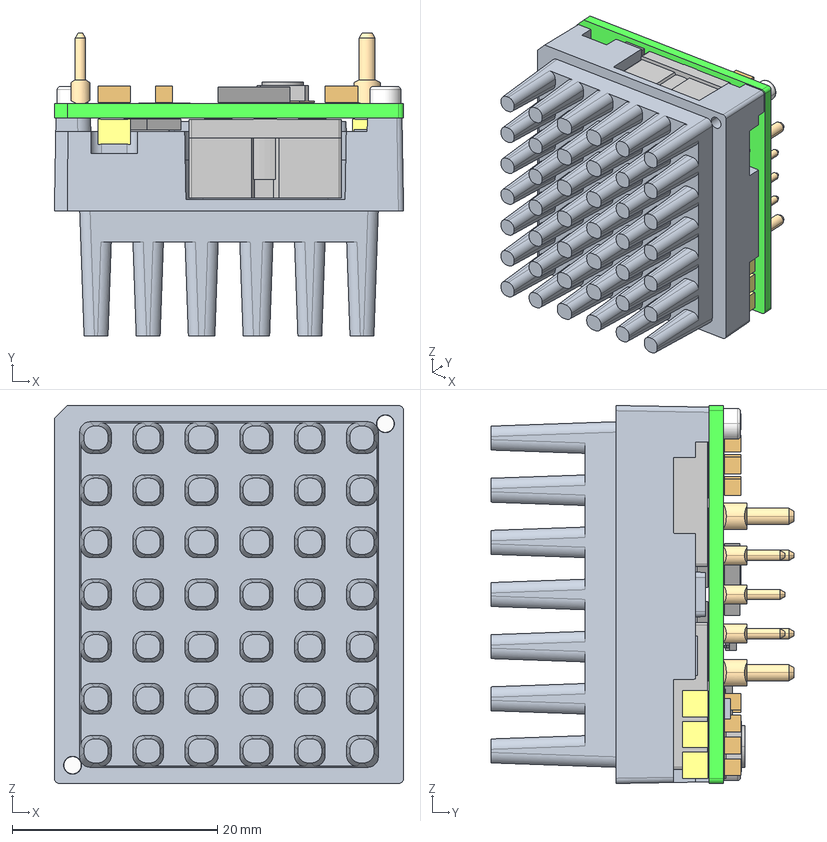
[picture p53: CAD file, 2024-11-08]
3D_models/i7A4W033A033V-xF3-R_TDK.step
34.0 x 29.5 x 36.8 mm
I7A_PWB
CDEP147 x 2
1210_CAP_2R5MM x 7
MLP_3MMX3MM x 8
1206_CAP_COLOR x 14
TQFP_7X7
CDC4D20_COLOR
0805_CAP_COLOR
0805_RES
LLP-8_COLOR
SC70-5_COLOR
ZP00206_01 x 2
ZP00166_01 x 4
ZP00232_01 x 4
AP00115_LABEL x 2
ZP00264_SIMPLE x 2
ZP00311_MP_00
