StickyEthan/ContinuO_Library/3D_models/XT60PW-F.step

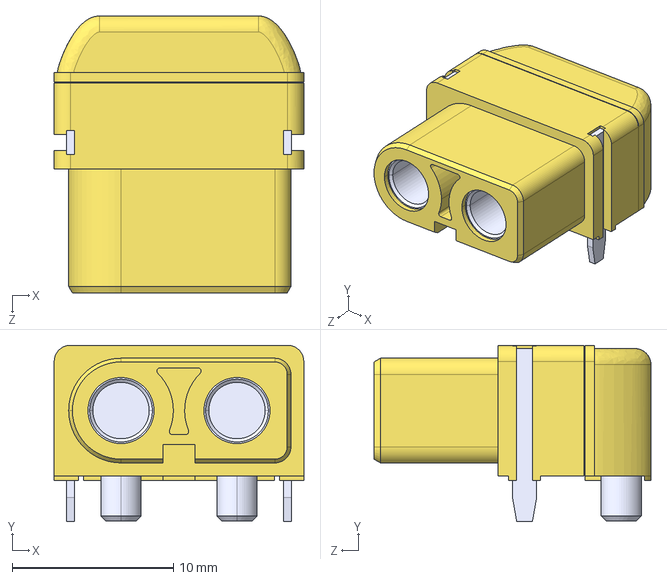
[picture p54: CAD file, 2024-11-08]
3D_models/XT60PW-F.step
15.5 x 10.9 x 17.2 mm
