StickyEthan/ContinuO_Library/3D_models/LM5069MMX-2_NOPB.step

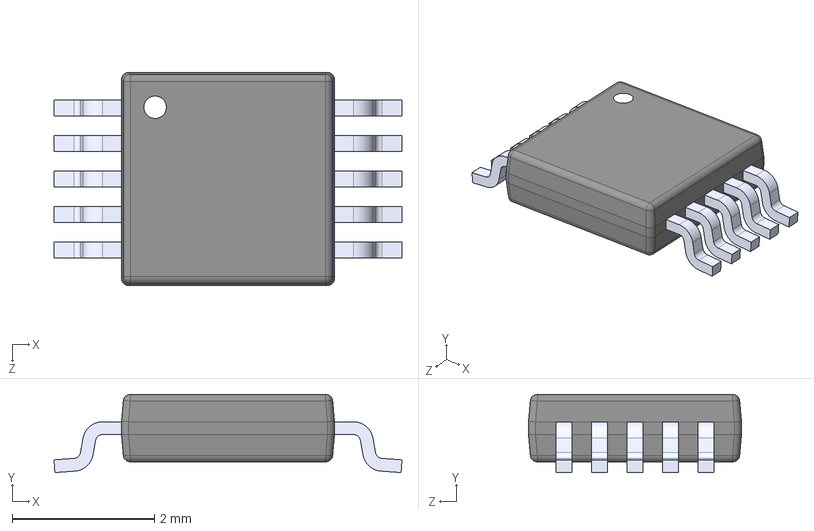
[picture p55: CAD file, 2024-11-08]
3D_models/LM5069MMX-2_NOPB.step
4.90 x 1.10 x 3.00 mm
