StickyEthan/ContinuO_Library/3D_models/XT90PW-F.step

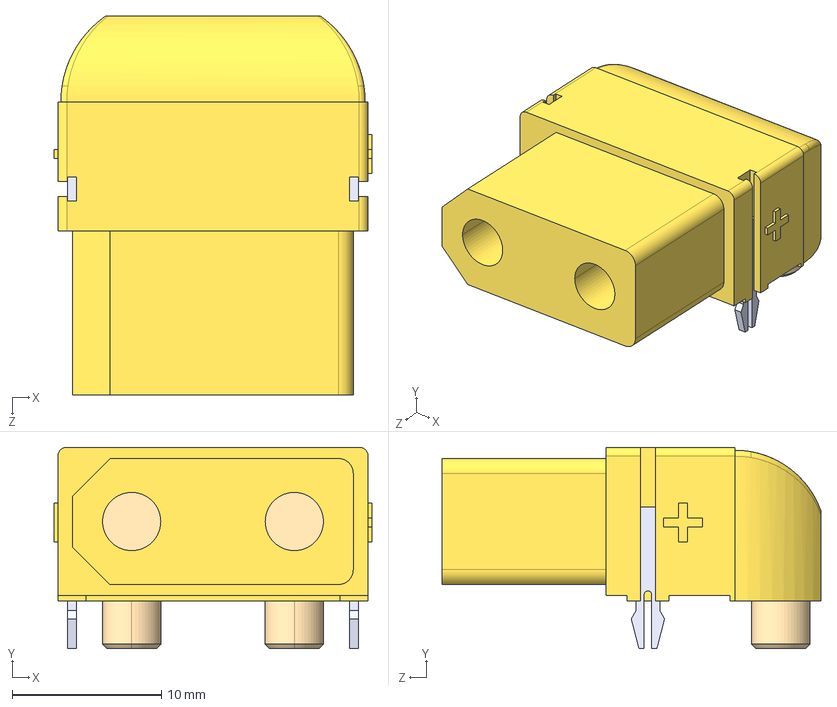
[picture p56: CAD file, 2024-11-07]
3D_models/XT90PW-F.step
21.3 x 13.5 x 25.4 mm
