StickyEthan/ContinuO_Library/(list of files, cad)

Other CAD files:
3D_models/A785MW187M1JLAS013.stp
3D_models/01220093Z.stp
3D_models/0157010.DR.STEP
3D_models/1217756-1.stp
3D_models/150080YS75000.stp
3D_models/196001300.stp
3D_models/62336-1.stp
3D_models/69103101002.step
3D_models/BMR6841100.step
3D_models/TPS259807ONRGER.stp
3D_models/WSL25122L000FEA.step
