StickyEthan/ContinuO_Library/(commit log)

2024-11-07 Adding Folders for files
    [XT90PW-F.step]
2024-11-07 Modify within 19V file
2024-11-08 Added Files For Components
    Added:
    - XT30M
    - XT60F
    - XT90M
    - XT90F
    - i7A4W033A033V
    - LM5069
    - RPMGS5020
    Added a folder for unfinished models:
    - BMR6841100 (I can only find the 3D Model)
    [BMR6841100.step, BMR6841100.stp, LM5069MMX-2_NOPB.step, XT30PW-M.step, XT60PW-F.step, XT90PW-M.step, i7A4W033A033V-xF3-R_TDK.step]
2024-11-08 Adding more Components
    Speaker (CPI-137-24T)
    LM4030CMF-4.096_NOPB
    Can't find:
    INA500BIDBVR
    TLP2662(D4-TP1,F)
    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
    [CPI-137-24T.step, LM4030CMF-4.096_NOPB.step, TLV1811DBVR--3DModel-STEP-740395.STEP]
2024-11-25 Adding Fuse Holders (10A, 16A)
    Components Added:
    16A Fuse holder - 0031.8241
    10A Fuse holder - 0031.8221
    [0031.8221.step, 0031.8241.step]
2024-11-25 Modified some footprints and replaced a 3d model
    - Replaced corrupted model for RPM
    - Modified multiple footprints
    [RPMGS12-20.stp]
2024-11-26 BMR6843 (48V Converter) Added
    I have added the footprint and schematic for the 48V converter (BMR684)
2024-11-27 Added UVLO parts rev 1
    [B02B-XASK-1.step, CMI-1210_CUD.step, CON4_2X2_TU_TSW_SAI.step, CPI-137-24T.step, D5V0P4URL6SO_7_SOT26_DIO.step, DBV0005A.stp, DBV0006A.stp, DS01C-254-S-04BE.step]
2024-11-27 2nd Update of UVLO Symbols and footprints, etc
    [150080YS75000.stp, D0014A.stp, LTV-826S_LTO.step, WCAP-AT1H_5X11.step]
2024-11-27 Moved 48V converter 3D model
    - Moved 48V converter 3D model
    - Removed model from the unfinished section
    [BMR6841100.step, BMR6841100.stp]
2024-11-28 Changes to ULVO connectors, fixed symbol-mapping to 3d models
    [B02B-PASK-1.step, HTSW-102-07-F-D.step, S03B-PASK-2_LF__SN_.stp, to252-4.stp]
2024-11-29 Adding Fuses
    Updated new fuses
    [69103101002.step, UMT-H.step, UMZ250.STEP]
2024-11-29 Updated BMR684 to have its heatsink 3D model
    [BMR684_heatsink.stp]
2024-11-30 Added fan PTC fuse and diode protections to library for 19/24V board
    [MF-MSMF075_24-2.step, TLV1811DBVR--3DModel-STEP-740395.STEP]
2024-11-30 Added PTC Fuse symbol, fpt, model
2024-12-02 Added E-fuse symbol, model, footprint
    [TPS259807ONRGER.stp]
2024-12-11 Added converter passive symbols, etc and updated DPAK LDO footprint and 3d models to have a heatsink
    [A785MW187M1JLAS013.stp, A785MW227M1HLAS015.stp, ESL108M035AK5AA.step, V-1100-SMD.STEP]
2024-12-31 Added power resistor, regen clamp components, some fets
    [DGK0008A.stp, HSE05-171933.step, LFPAK88_SOT1235_NEX.step, PF2203_2RF1.step]
2025-01-02 Added shunt resistor
    [WSL25122L000FEA.step]
2025-01-02 Added a capacitor for testing purposes
    [CAP_YX_12P5X25_RUB.step]
2025-01-08 Modified some footprints slightly
    I didn't like how some of the silkscreen marking were on the following footprints:
    - XT30-M
    - XT90-M
    - XT90-F
    - CONN_S03...
2025-01-09 Added additional op-amp, fets, ideal-diode controller, made minor updates to symbol pin types to remove electrical-rule-check errors
    [DDF0008A.stp]
2025-01-12 Added Regen Capacitors, TVL9351 IC for regen, minor fixes to footprint silk screen for regen
    [CAP_BX_12P5x30_RUB.step]
2025-01-13 Added 2-pin right angle JST connector for seperate regen-power input
    [S02B-PASK-2.STEP]
2025-01-14 Fixed some DRC footprint errors for some IC's, added components for Regen clamp - Final, added footprints for FET's with heatsinks for reduced zone-area, minor updates
    [217-36CTE6.stp, CAP_PKPZ_8X11P5_LOW_RUB.step, RDA0015A.stp, Same_Sky_TBP01P1-508-02BE.step, Shunt Resistor v2.step, TBP01R2-508-02BE.step, TBP01R2-508-02BE_male.step]
2025-01-14 Added 5A and 8A fuses
    both share the UMF250 Models
    [UMF250.STEP]
2025-01-16 Added failsafe fuses in case of project fails to ensure minimum OCP functionality can be mantained
    [01220093Z.stp, FUSE_0505-CARTRIDGE_LTF.step]
2025-01-17 Added New Fusing
    [0157010.DR.STEP]
2025-01-19 Edited vias out of footprint to ensure standard PCB
2025-01-23 Updated thermal IC, added additional FET's
2025-01-24 Fixed footprints for fets, and pin assignemnt for no-connect on tl431
2025-01-27 Found Alterative Connector for Regen-resistor connection
    [1211.stp, 1217756-1.stp, 196001300.stp, 62336-1.stp, c-62395-1-ae-3d.stp]
2025-01-30 Addd virtual bus bar model for 48V pcb
    [bus_bar v2.step]
2025-01-31 Added different lm5069 footprints with larger solder-mask bridges between pins
2025-01-31 Added XT60PW-M
    I was lazy and only made the footprint and 3D model. It shares a symbol with the xt60pw-f
    [XT60PW-M.STEP]
2025-02-28 Fixed 48V board Diode issue by renaming pin numbers to match default kicad footprint
2025-03-07 Updated 24V conv. to sep model as derrived footprint
