StickyEthan/ContinuO_Library/(notices)

Notices in the files:
3D_models/HTSW-102-07-F-D.step:
author */ ('License CC BY-ND 4.0'),
